ukaratas/NeoPLC/di_field.png

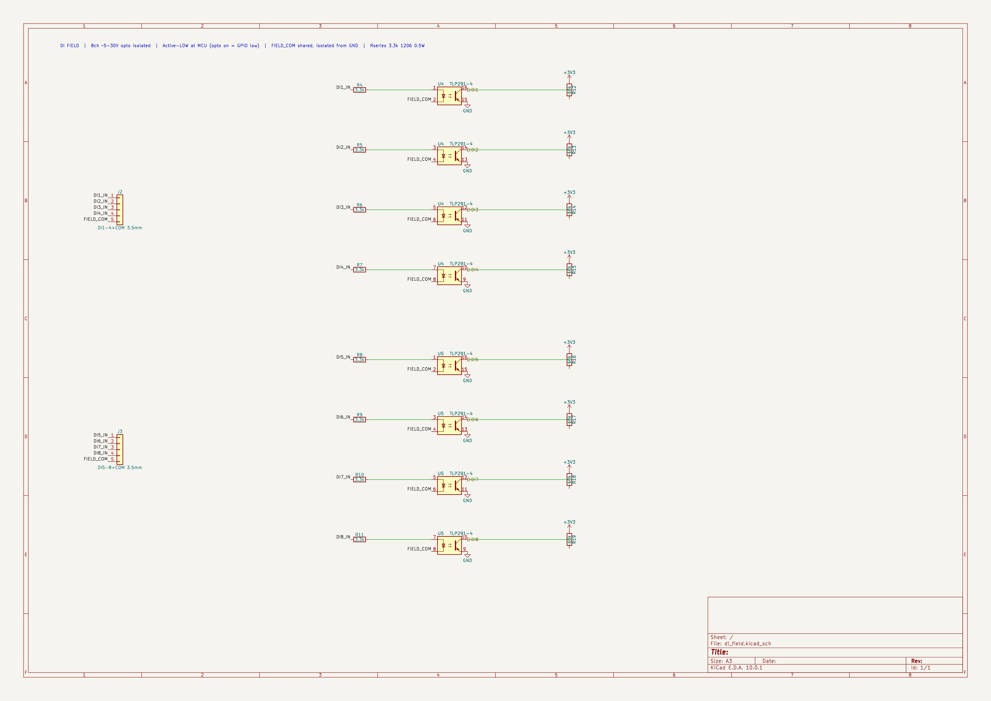
di_field.png
