ukaratas/NeoPLC/NeoPLC.png

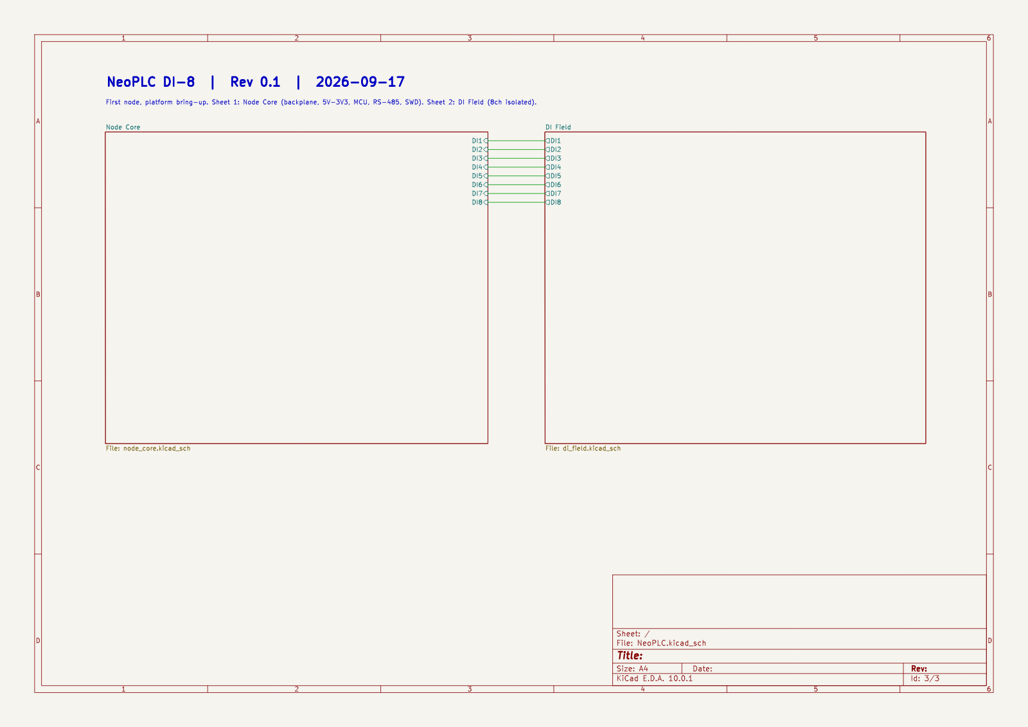
NeoPLC.png
