ukaratas/NeoPLC/node_core.png

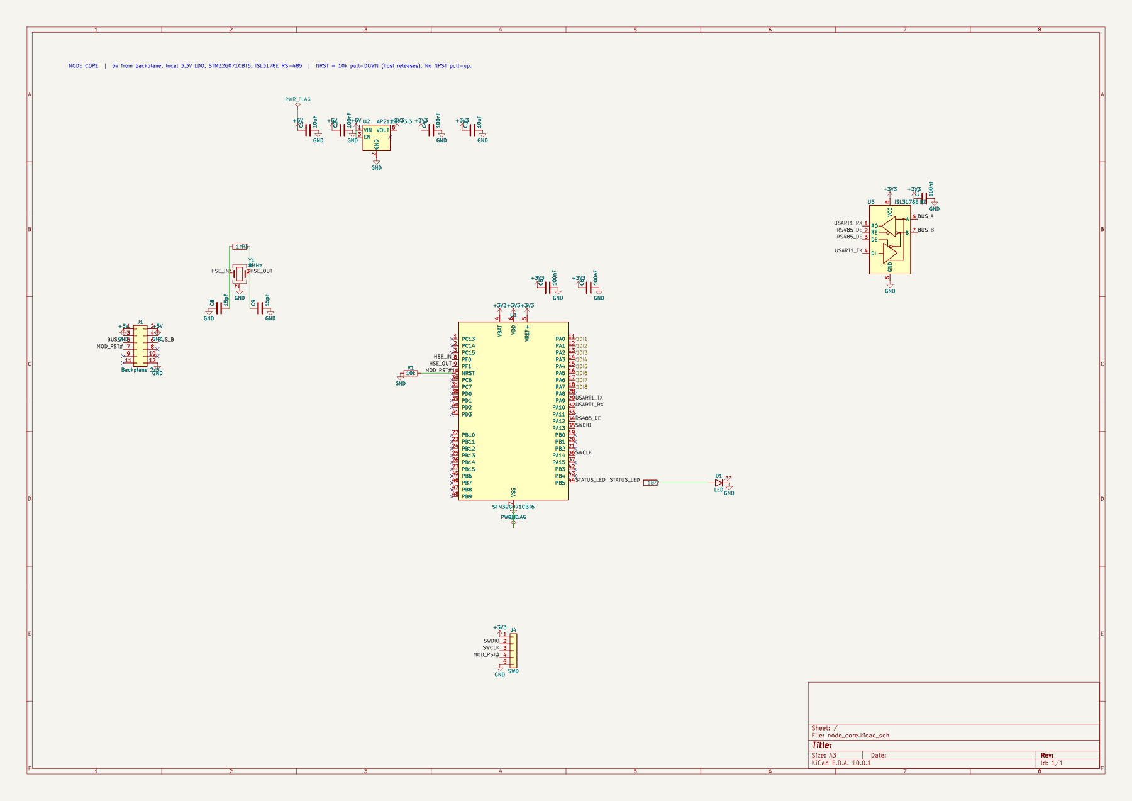
node_core.png
