ukaratas/NeoPLC/NeoPLC.kicad_pcb

## KiCad design NeoPLC.kicad_pcb (2026-09-21)

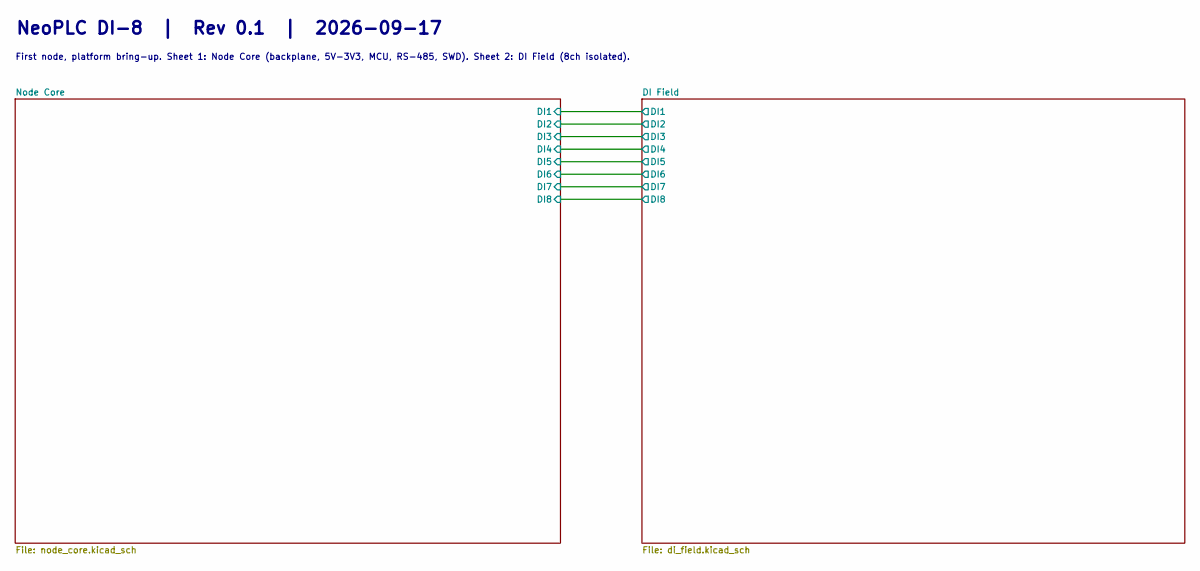
[picture p4: schematic NeoPLC.kicad_sch]

Notes on the sheet:
NeoPLC DI-8 | Rev 0.1 | 2026-09-17
First node, platform bring-up. Sheet 1: Node Core (backplane, 5V-3V3, MCU, RS-485, SWD). Sheet 2: DI Field (8ch isolated).

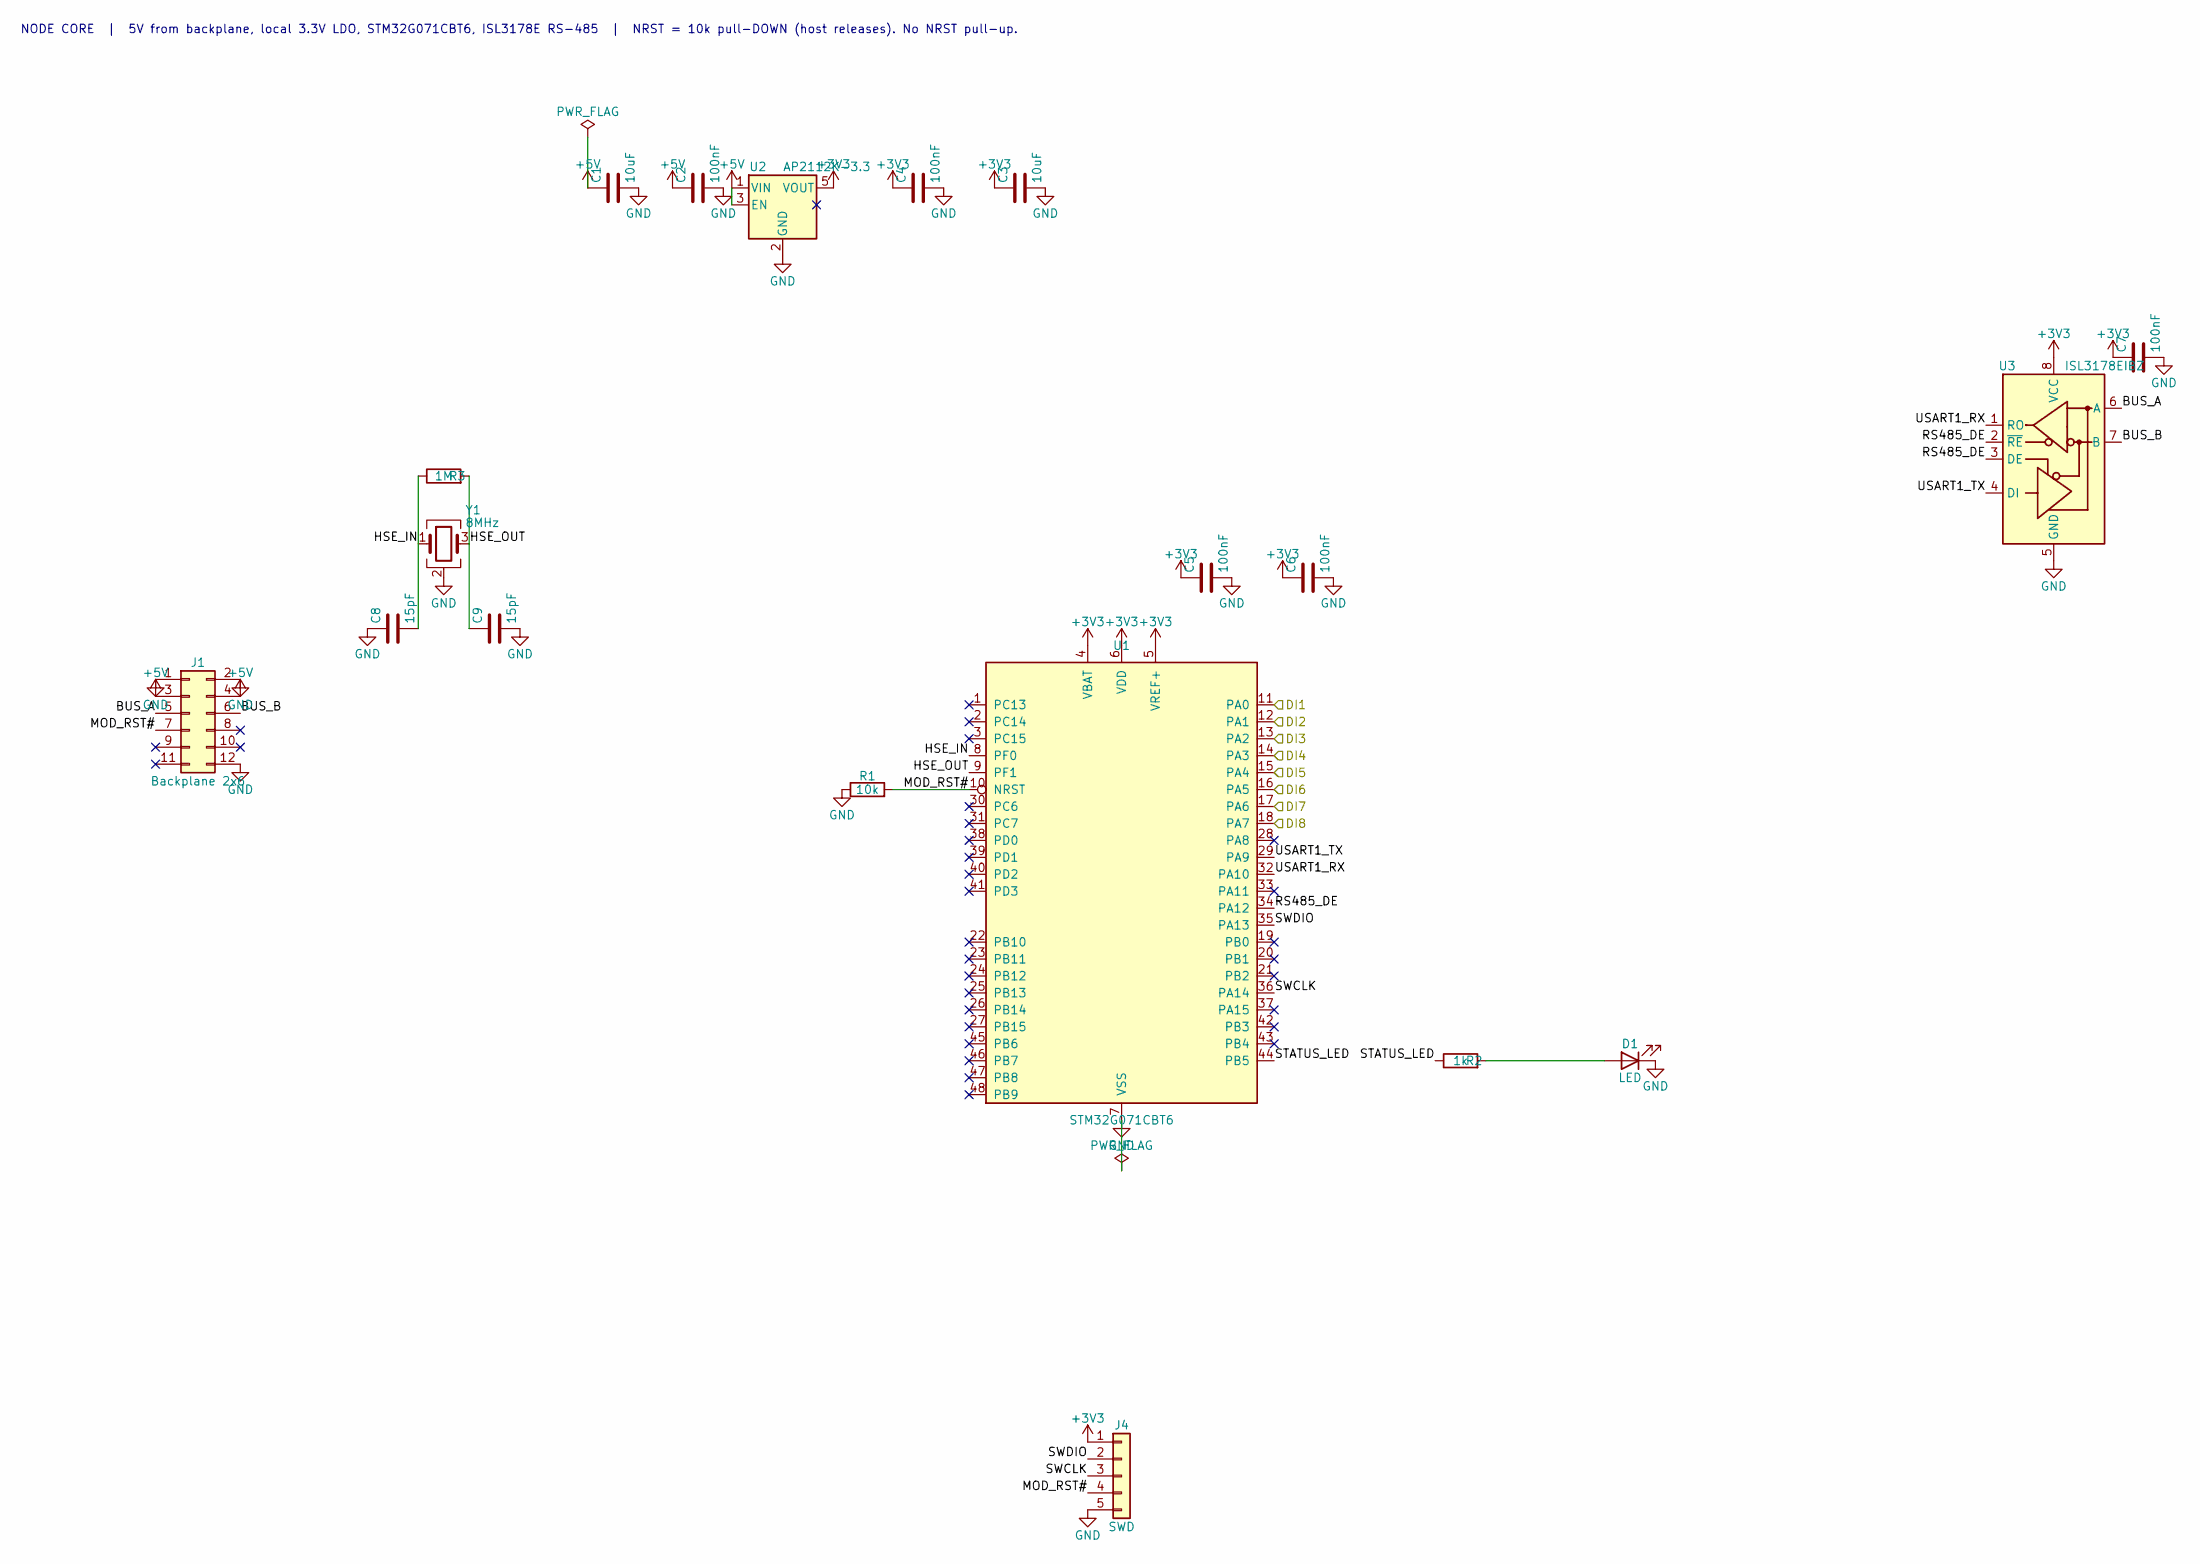
[picture p5: schematic node_core.kicad_sch]

Parts:
C1, C3: 10uF; C_0805_2012Metric
C2, C4, C5, C6, C7: 100nF; C_0402_1005Metric
C8, C9: 15pF; C_0402_1005Metric
D1: LED; LED_0805_2012Metric
J1: Backplane 2x6; GoldFinger_2x6_2.54
J4: SWD; PinHeader_1x05_P2.54mm_Vertical
R1: 10k; R_0402_1005Metric
R2: 1k; R_0402_1005Metric
R3: 1M; R_0402_1005Metric
U1: STM32G071CBT6; LQFP-48_7x7mm_P0.5mm; MPN STM32G071CBT6
U2: AP2112K-3.3; SOT-23-5; MPN AP2112K-3.3TRG1
U3: ISL3178EIBZ; SOIC-8_3.9x4.9mm_P1.27mm; MPN ISL3178EIBZ
Y1: 8MHz; Crystal_SMD_3225-4Pin_3.2x2.5mm

Connections:
+3V3: C3.1, C4.1, C5.1, C6.1, C7.1, J4.1, U1.4 (VBAT), U1.5 (VREF+), U1.6 (VDD), U2.5 (VOUT), U3.8 (VCC); also elsewhere on the board
/DI Field/DI1: U1.11 (PA0); also elsewhere on the board
/DI Field/DI2: U1.12 (PA1); also elsewhere on the board
/DI Field/DI3: U1.13 (PA2); also elsewhere on the board
/DI Field/DI4: U1.14 (PA3); also elsewhere on the board
/DI Field/DI5: U1.15 (PA4); also elsewhere on the board
/DI Field/DI6: U1.16 (PA5); also elsewhere on the board
/DI Field/DI7: U1.17 (PA6); also elsewhere on the board
/DI Field/DI8: U1.18 (PA7); also elsewhere on the board
/Node Core/BUS_A: J1.5, U3.6 (A)
/Node Core/BUS_B: J1.6, U3.7 (B)
/Node Core/HSE_IN: C8.2, R3.1, U1.8 (PF0), Y1.1
/Node Core/HSE_OUT: C9.1, R3.2, U1.9 (PF1), Y1.3
/Node Core/MOD_RST#: J1.7, J4.4, R1.2, U1.10 (NRST)
/Node Core/RS485_DE: U1.34 (PA12), U3.2 (~RE), U3.3 (DE)
/Node Core/STATUS_LED: R2.1, U1.44 (PB5)
/Node Core/SWCLK: J4.3, U1.36 (PA14)
/Node Core/SWDIO: J4.2, U1.35 (PA13)
/Node Core/USART1_RX: U1.32 (PA10), U3.1 (RO)
/Node Core/USART1_TX: U1.29 (PA9), U3.4 (DI)
unnamed: D1.2 (A), R2.2

Notes on the sheet:
NODE CORE | 5V from backplane, local 3.3V LDO, STM32G071CBT6, ISL3178E RS-485 | NRST = 10k pull-DOWN (host releases). No NRST pull-up.

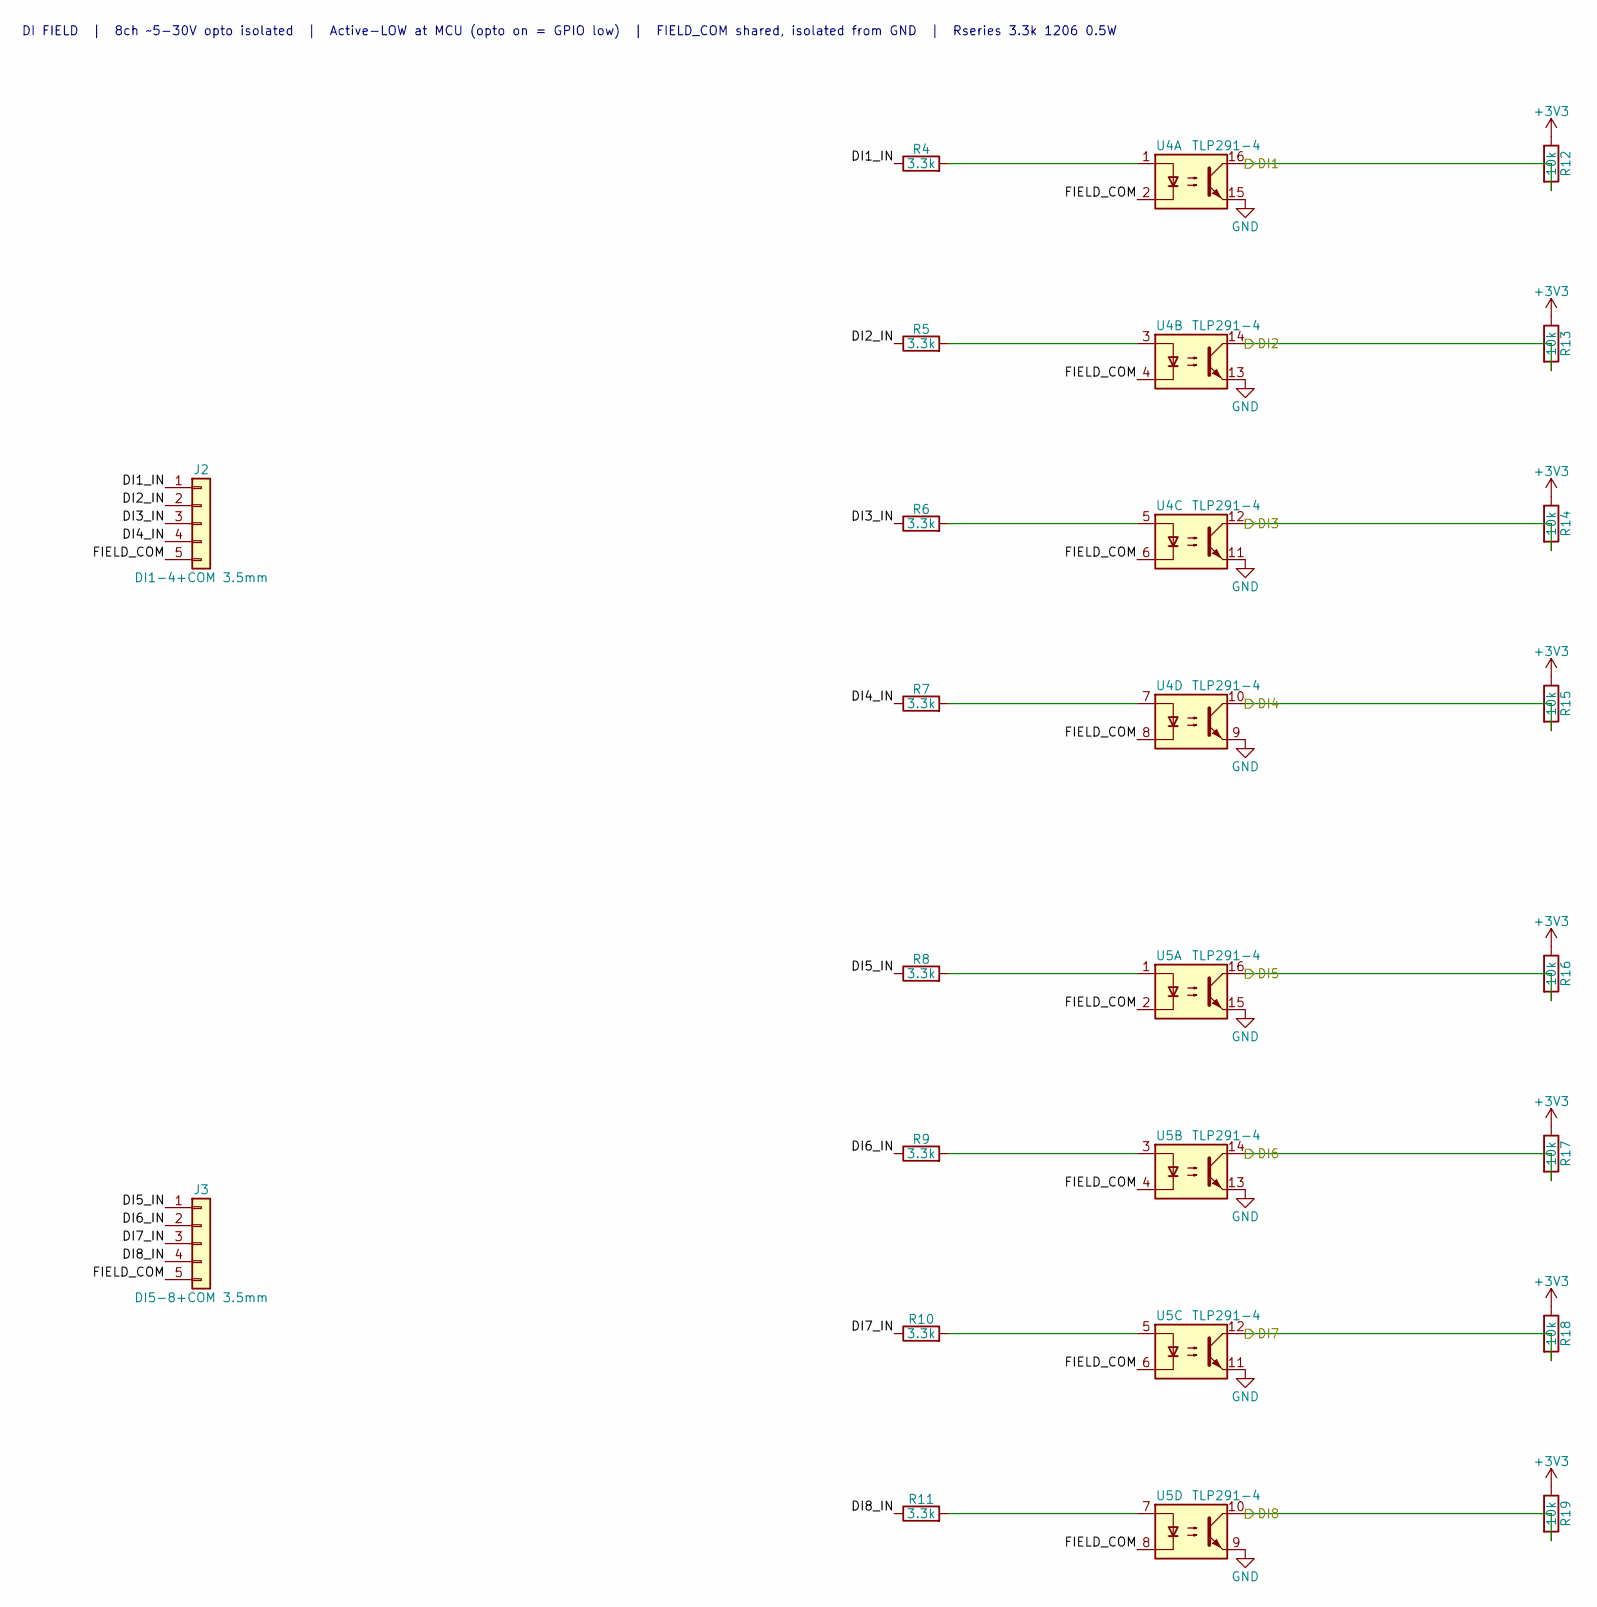
[picture p6: schematic di_field.kicad_sch]

Parts:
J2: DI1-4+COM 3.5mm; PhoenixContact_MCV_1,5_5-G-3.5_1x05_P3.50mm_Vertical
J3: DI5-8+COM 3.5mm; PhoenixContact_MCV_1,5_5-G-3.5_1x05_P3.50mm_Vertical
R4, R5, R6, R7, R8, R9, R10, R11: 3.3k; R_1206_3216Metric
R12, R13, R14, R15, R16, R17, R18, R19: 10k; R_0402_1005Metric
U4, U5: TLP291-4; SOIC-16_4.55x10.3mm_P1.27mm; MPN TLP291-4

Connections:
+3V3: R12.1, R13.1, R14.1, R15.1, R16.1, R17.1, R18.1, R19.1; also elsewhere on the board
/DI Field/DI1: R12.2, U4.16; also elsewhere on the board
/DI Field/DI1_IN: J2.1, R4.1
/DI Field/DI2: R13.2, U4.14; also elsewhere on the board
/DI Field/DI2_IN: J2.2, R5.1
/DI Field/DI3: R14.2, U4.12; also elsewhere on the board
/DI Field/DI3_IN: J2.3, R6.1
/DI Field/DI4: R15.2, U4.10; also elsewhere on the board
/DI Field/DI4_IN: J2.4, R7.1
/DI Field/DI5: R16.2, U5.16; also elsewhere on the board
/DI Field/DI5_IN: J3.1, R8.1
/DI Field/DI6: R17.2, U5.14; also elsewhere on the board
/DI Field/DI6_IN: J3.2, R9.1
/DI Field/DI7: R18.2, U5.12; also elsewhere on the board
/DI Field/DI7_IN: J3.3, R10.1
/DI Field/DI8: R19.2, U5.10; also elsewhere on the board
/DI Field/DI8_IN: J3.4, R11.1
/DI Field/FIELD_COM: J2.5, J3.5, U4.2, U4.4, U4.6, U4.8, U5.2, U5.4, U5.6, U5.8
unnamed: R4.2, U4.1
unnamed: R5.2, U4.3
unnamed: R6.2, U4.5
unnamed: R7.2, U4.7
unnamed: R8.2, U5.1
unnamed: R9.2, U5.3
unnamed: R10.2, U5.5
unnamed: R11.2, U5.7

Notes on the sheet:
DI FIELD | 8ch ~5-30V opto isolated | Active-LOW at MCU (opto on = GPIO low) | FIELD_COM shared, isolated from GND | Rseries 3.3k 1206 0.5W

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
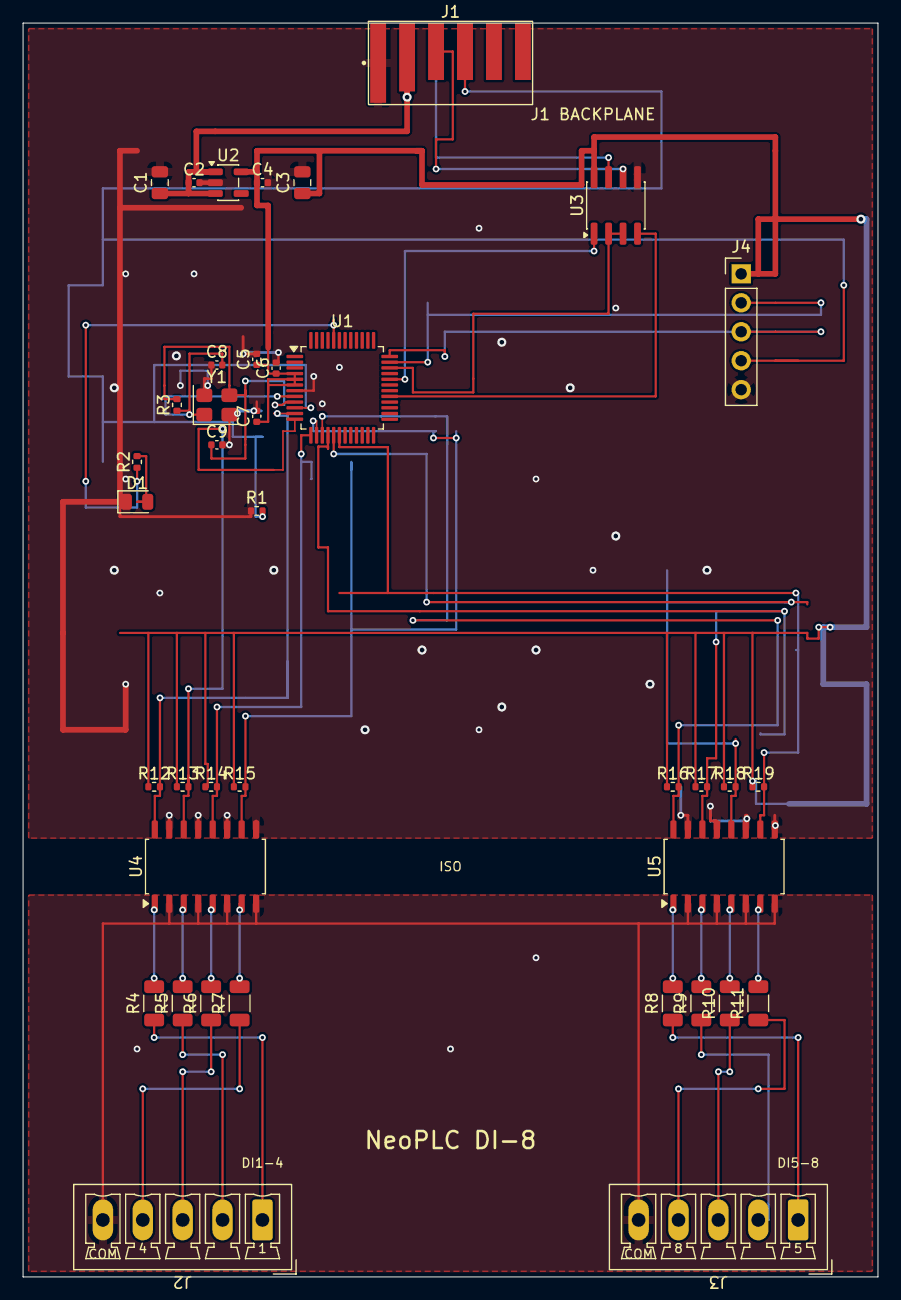
[picture p7: board NeoPLC.kicad_pcb from above]

Board: 2 copper layers, 75.0 x 110.0 mm, 39 parts (0 on the bottom side), 40 nets.
