ukaratas/NeoPLC/(commit log)

2026-09-16 Sistem mimarisi dokümantasyonu ve KiCAD proje iskeleti
    NeoPLC: 12-48V DC, 8U modüler PLC / remote I/O platformu.
    İlk hedef uygulama karavan yönetimi (batarya beslemeli, 60°C ortam).
    docs/ — 13 doküman, 59 kararlık karar kütüğü (D-01..D-59):
    - Karar kütüğü tek kaynak; şema çizilmeden önce kararlar 🟢 olmalı
    - Master: ESP32-S3-WROOM-1U + W5500 (onaylandı)
    - Güç: 12-48V ön kat, ikili rail (VBUS_RAW + 5V_SYS), 2A tasarım noktası
    - Backplane: kart kenarı 26 pin, 4 kademeli mate, coğrafi slot adresleme
    - Dahili bus: RS-485 diferansiyel, 500 kbaud, katı master-slave + FAULT# event
    - Enerji bütçesi (birincil kısıt): S0-S3 güç durumları, wake-on-bus,
    5.5 Wh/g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
    [NeoPLC.kicad_pcb, NeoPLC.kicad_sch]
2026-09-16 Gerçek blade mimarisi: kutu-içinde-kutu terk edildi (D-60)
    Çalışma draftındaki "kutuya kutular bağlanıyor" yaklaşımı yerine, içinde
    kızakları olan gerçek bir mini blade şasisi. Node'lar çıplak PCB + ön panel.
    Dört gerekçe:
    - Termal (belirleyici): plastik muhafaza her node'un etrafına ~0.2 W/mK
    yalıtım katmanı koyuyordu. Blade'de PCB doğrudan hava kanalında.
    - Maliyet: muhafaza başına $2-5, 8 node'da $16-40 — K1'e aykırı
    - Titreşim (K5): kızak PCB'yi 110 mm boyunca iki kenarından destekliyor;
    kutu içinde 4 vidayla tutulan PCB'nin rezonans frekansı çok daha düşük
    - Hizalama: kart kenarı konnektörünün ihtiyacı olan giriş açısı garantisi
    0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
2026-09-16 docs/img: mimari görseller (SVG)
    Beş teknik görsel, elle yazılmış SVG olarak — GitHub'da doğrudan render
    oluyor, versiyonlanabiliyor, metin editöründe düzenlenebiliyor.
    01 Sistem ön görünüm — 8 slot, karışık 1U/2U yerleşim, ölçüler
    02 Blade şasi üstten kesit — kızak rayları, backplane, takma yönü, oluk detayı
    03 1U node anatomisi — çıplak PCB + ön panel, bileşen yükseklik bütçesi
    04 Kart kenarı stagger — 26 pin, 4 kademeli mate sırası, pin dizilimi
    05 Hava akışı — blade kanalları, fan, 1.6 CFM debi hesabı
    Hepsi qlmanage ile PNG'ye çevrilip görsel olarak doğrulandı; çakışan
    etiketler ve yön tutarsızlıkları düzeltildi (05'te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
2026-09-16 WiFi talep üzerine (D-65) · Host 2U blade, özel slot (D-66)
    D-65 WiFi varsayılan kapalı, butonla 10 dk açılır
    Hesap: WiFi'ı tamamen atmakla talep üzerine açmak arasında sadece
    %14 fark var (1.9 vs 2.2 Wh/gün). Yani WiFi'ın maliyeti varlığı değil,
    sürekli bağlı kalması. Tamamen atmak ise ESP32'den vazgeçmeyi ve yerine
    fiziksel HMI koymayı gerektirir — bir ekran 200mW-1W, yani WiFi'dan pahalı.
    Enerji bütçesi 3.5 -> 2.2 Wh/gün, batarya ömrü 170 -> 273 gün.
    D-67 açıldı: BLE ile butonsuz uyandırma (~1-3 mW) değerlendirilecek.
    D-66 Host = 2U blade, kendi özel slotunda (node kapasitesi tüketmez)
    Ayrı host bölmesi gereksizdi. Blade mimarisinde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
2026-09-16 Backplane 26 -> 12 pin: uçtan uca sadeleştirme
    Pin sayısı sorgulandı ve yarıdan fazlası gereksiz çıktı. Tek tek:
    GND x4 -> x2 (D-32)
    1U node max 150 mA, röle darbesi ~160 mA tepe. Tek 2.54 mm gold finger
    kontağı 1-3 A taşır — akım için 1 pin bile fazlasıyla yeterli.
    İkinci pin akım için değil, titreşim altında kontak redundansı için (K5).
    3. ve 4. pinin hiçbir gerekçesi yoktu.
    VBUS_RAW (12-48V) kaldırıldı, tek +5V rayı (D-08)
    Backplane'den >5V isteyen tek aday analog çıkış 0-10V compliance'ıydı.
    O node'a ~$0.30 lokal boost koymak, 8 slota 2 pin + backplane boyunca
    yüksek gerilim dağıtmaktan ucuz ve güvenli. Backplane artık tamamen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
2026-09-16 Tek ray koşulsuz (D-08) · anlık akım yönetimi (D-68)
    Bobin gerilimi artık bir bağımlılık değil
    5V'tan yüksek bobin gerekiyorsa yükseltme node üzerinde yapılıyor —
    küçük boost ya da gerilim katlayıcı, ~$0.20-0.30. Tek ray kararı
    koşulsuz hale geldi; parça tedariği kararı geri açamaz.
    Bobin GÜCÜ gerilimden bağımsız (~300 mW), o yüzden 12V bobin + boost
    5V bobinle neredeyse aynı 5V-tarafı akımını çekiyor (%18 fark).
    Yan kazanç: latching röle aramasında tek kısıt kaldı — yükseklik (D-61).
    Bobin gerilimi artık filtre değil, arama alanı belirgin genişledi.
    D-68 Anlık akım yönetimi
    Bobin başına 5V tarafı ~70 mA. Raf tepe a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
2026-09-17 Consistency review: kabul edilmiş kararlarla çelişen eski ifadeleri temizle
    Repo geneli uçtan uca tarama. Yeni mimari karar üretilmedi — yalnız mevcut
    kabul edilmiş kararların tek ve tutarlı biçimde ifade edilmesi sağlandı.
    Karar kütüğü (00):
    - D-02: W5500 host Ethernet kontrolcüsü gibi "kabul edildi" görünüyordu,
    D-47 ile doğrudan çelişiyordu. Kapsamı gelecekteki Ethernet haberleşme
    node'una daraltıldı
    - D-14 (26 pin): 🟡 aktif öneri gibi duruyordu → ⛔ superseded by D-32
    - D-25: "BOOT# donanım kaçışı" diyordu; BOOT# D-19 ile kaldırılmıştı →
    RST# + bootloader penceresi
    - D-52, D-56: kabul listesinde 🟢, tabloda 🟡 →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
2026-09-18 DI-8 şema ve PCB taslağı: platform kararları kilitlendi, çekirdek/saha yerleşimi GitHub’da.
    Birkaç saatlik stabil anlarda origin’e push kuralı eklendi; yerel KiCAD geçmişi ve Konnect önizlemeleri commit dışı bırakıldı.
    [NeoPLC.kicad_pcb, NeoPLC.kicad_sch, di_field.kicad_sch, node_core.kicad_sch]
2026-09-18 DI6/DI4 last-mile ve J1 +5V arka pad: MCU’ya bakır kapandı, DRC 134→101.
    [NeoPLC.kicad_pcb]
2026-09-19 +3V3 LDO–MCU köprüsü ve RST/DI ada dikişleri: DRC 98→83.
    [NeoPLC.kicad_pcb]
2026-09-19 DI8 ada dikişleri, GND via’lar ve SWDIO/STATUS jog: DRC 81→74.
    Pad–pull-up netleri kapalı; silinemeyen via kısa devreleri ve J1 gold-finger kenar boşluğu kaldı.
    [NeoPLC.kicad_pcb]
2026-09-19 Saha FIELD_COM arka pour ve DI2 ada dikişi: DRC yine 74.
    Izole ada F/B birleşti; DI8_IN via’dan kaçırıldı. Silinemeyen via kısa devreleri aynı üç çift.
    [NeoPLC.kicad_pcb]
2026-09-21 DI2/+3V3 ada dikişi, COM ipek ve GND via’lar: DRC 74→73.
    Doğu +3V3 omurgaya bağlandı; DI7 doğu via’sı last-mile’a girdi. Silinemeyen üç via kısa devresi aynı.
    [NeoPLC.kicad_pcb]
2026-09-21 DI5 ada via 34.2 dikişi ve C5 GND pour: DRC 73→77.
    Doğu DI6 hop +3V3/DI8’e girdi, geri alındı. 15.9,30 via RST# oldu (silinemez). Üç kısa devre aynı.
    [NeoPLC.kicad_pcb]
2026-09-21 Konnect delete_via eksiği için IPC köprü; pad-yanı via’lar silindi, DRC 69→54.
    [NeoPLC.kicad_pcb]
2026-09-21 DI3/5/6/7 MCU–saha kapandı, ada via’lar silindi: DRC 54→43, kısa yok.
    [NeoPLC.kicad_pcb]
2026-09-21 DI1 ve DI4 MCU kaçışı kapandı: 8 DI saha yolu tamam, DRC 43→42, kısa yok.
    [NeoPLC.kicad_pcb]
2026-09-21 C7, Y1 ve U5 GND dikişi; HSE yığın via silindi: DRC 42→37, kısa yok.
    [NeoPLC.kicad_pcb]
2026-09-21 U1 pad7, C2 ve U5 pad13 GND kapandı: DRC 37→33, kısa yok.
    [NeoPLC.kicad_pcb]
2026-09-21 C6 ve R1 GND kaçışı: DRC 33→29, kısa yok, açık uç sadece pour adası.
    [NeoPLC.kicad_pcb]
2026-09-21 C7 via, +3V3 omurga ve DI7 kaçışı: DRC 29→26, kısa yok.
    [NeoPLC.kicad_pcb]
2026-09-21 DI5 yanındaki GND via çıktı: DRC 26→25, kısa yok.
    [NeoPLC.kicad_pcb]
2026-09-21 U4 GND adaları via ile kapandı: DRC açık uç 3→0.
    [NeoPLC.kicad_pcb]
2026-09-21 GND adaları kapandı; DI7/+3V3 ve RST kaçışı: DRC 16, kısa yok.
    [NeoPLC.kicad_pcb]
2026-09-21 RST via doğuya alındı; pad9 kaçışı kapandı, kısa yok.
    [NeoPLC.kicad_pcb]
2026-09-21 Y1 pad4 C8 GND’ye bağlandı; kristal pad2 adası duruyor.
    [NeoPLC.kicad_pcb]
2026-09-21 DI4 via yeniden 25.75: DI3 kaçışı geri geldiği için.
    [NeoPLC.kicad_pcb]
2026-09-21 Saha izolasyon bariyeri DRC ile korunuyor: Field netclass + 4 mm kural.
    Saha tarafı (DIx_IN, FIELD_COM, seri direnç-opto anot netleri) ile mantık
    tarafı arasında tek zorlanan kısıt 0.15 mm Default clearance'tı; bariyeri
    koruyan hiçbir kural yoktu. 17 saha neti Field netclass'ine alındı ve
    NeoPLC.kicad_dru ile aralarına 4.0 mm zorlandı.
    Ölçüm: karttaki en dar saha<->mantık aralığı 4.900 mm ve opto paketinin
    kendisinde (U4/U5 pin 1<->16). Sınırlayan şey routing değil, SOIC-16 gövdesi.
    4.0 mm mevcut layout'ta sıfır ihlal veriyor, pakete ~0.9 mm pay bırakıyor.
    DRC değişmedi: 16 error / 200 warning.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
2026-09-21 Gercek DRC hatalari bitti: 16 -> 12, kalan 12'si J1 gold finger.
    Y1 pad2/pad4: GND iki bilesene ayrilmisti; kristal cevresindeki F#12/F#13 ve
    B#1 dolgulari ana govdeye hic baglanmiyordu. F#13'ten ana B.Cu dolgusuna via
    (13.45,29.2) ile kapandi. Acik uc 1 -> 0.
    HSE_OUT kacisi: via (22.9,33.25) pad8 izine 0.100 mm ve U1 pad8'e 0.131 mm
    yakindi. Pad8-pad9 arasi 0.5 mm oldugu icin 0.6 mm via o hatta hicbir sekilde
    sigmiyor. Kacis pad10 koridoruna alindi: via (22.1,33.5), pay 0.176 mm.
    DI4 kacisi: via (25.75,35.2) DI5 kolonuna 0.125 mm yakindi. Via (25.45,34.9)
    konumuna alindi, pay 0.254 mm.
    Zone refill sonrasi: 12 error (hepsi gold finger), unconnected 0, 200 warning.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
    [NeoPLC.kicad_pcb]
2026-09-21 KiCAD, Field netclass girdisini normalize etti (renk/tuning alanlari).
2026-09-21 95 dangling via silindi: DRC 212 -> 151, baglanti bozulmadi.
    Via'lar tanim geregi en fazla tek katmanda bagliydi, yani hicbir baglanti
    tasimiyorlardi; silindikten sonra unconnected 0 kaldi. holes_co_located 9->6,
    hole_to_hole 8->3. track_dangling 19->61'e cikti: o via'lara giden izlerin
    uclari artik bosta, ayri is olarak budanacak.
    Toptan iz silmedim: her iz parcasinin bir pad'e ulasip ulasmadigini net bazinda
    birlesim-bul ile cikardim, pad'e hic ulasmayan parca sayisi 0. Yani bosta uclar
    canli yollarin uzerinde, yetim bakir degil.
    kicad-via-bridge: basarili bir silmeden sonra dogrulama adimi cokuyordu.
    Sebep kipy'de ApiError.raw_message'in `return self.raw_message` olmasi -
    ozelliye dokun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
    [NeoPLC.kicad_pcb]
2026-09-21 Olu bakir budandi: 79 cikinti segmenti, DRC 151 -> 111.
    Her segment icin "sildiginde bu netin padlerinin baglanti bolumlemesi
    degisiyor mu" testi yapildi; degistirenlere dokunulmadi. 55.5 mm'lik +3V3
    omurgasi bu testte yuk tasidigi icin yerinde kaldi.
    Bir regresyon oldu ve duzeltildi: modelde PTH padlerin katman kumesini
    "*.Cu" yerine F.Cu olarak okumustum, bu yuzden J3 pad2'ye giden B.Cu yolu
    gereksiz gorundu ve silindi (unconnected 1). DI6_IN yolu eski haliyle geri
    konuldu.
    Simdi: 12 error (hepsi J1 gold finger), unconnected 0, 99 warning.
    track_dangling 61 -> 18, via_dangling 0 -> 3 (budama sonrasi yeni olusan).
    [NeoPLC.kicad_pcb]
2026-09-21 Footprintler kutuphaneden tazelendi: DRC 111 -> 72.
    39 footprint'in tamaminda lib_footprint_mismatch vardi. Uygulamadan once
    kartdaki pad geometrisini kutuphane .kicad_mod dosyalariyla tek tek
    karsilastirdim: tek fark pad'lerin rotasyon alani (R4/U4 90 derece, J2/J3
    180 derece yerlestirildigi icin yerlestirilmis ornek mutlak rotasyonu
    tutuyor). Gercek bir boyut/konum kaymasi yok, yani padler oynamayacakti.
    Update Footprints from Library tek undo commit'i olarak uygulandi; konum,
    rotasyon, pad netleri ve kiid korundu. Sonuc: 12 error (hepsi J1 gold
    finger), unconnected 0, 60 warning.
    [NeoPLC.kicad_pcb]
2026-09-21 Delik hijyeni: ust uste ve cakisan via'lar temizlendi, DRC 72 -> 62.
    6 cift birebir ayni koordinatta via vardi (delik dosyasinda ayni noktaya iki
    vurus; fab icin gercek risk) ve 3 cift 0.1-0.2 mm arayla cakisiyordu. Her
    ciftten biri birakildi. Ardindan tek katmanda kalan 6 via da silindi.
    holes_co_located 6 -> 0, hole_to_hole 3 -> 0, via_dangling 3 -> 0.
    unconnected her adimda 0 kaldi.
    [NeoPLC.kicad_pcb]
2026-09-21 Klemens kanal etiketleri 0.7 -> 0.8 mm: DRC 62 -> 58.
    J2 ve J3'un '1','4','5','8' etiketleri 0.7 mm'ydi, kartin kendi ipek alt
    siniri 0.8 mm. Yanlarindaki COM etiketleri zaten 0.8 idi; tutarli hale
    getirildi. text_height 4 -> 0.
    [NeoPLC.kicad_pcb]
